nechet/zx-spectrum-fpga-tang-nano-20k/Krasnodar-48-fpga/KiCad-US/Krasnodar-48-US.kicad_sch

## KiCad design Krasnodar-48-fpga/KiCad-US/Krasnodar-48-US.kicad_sch (2026-10-19)

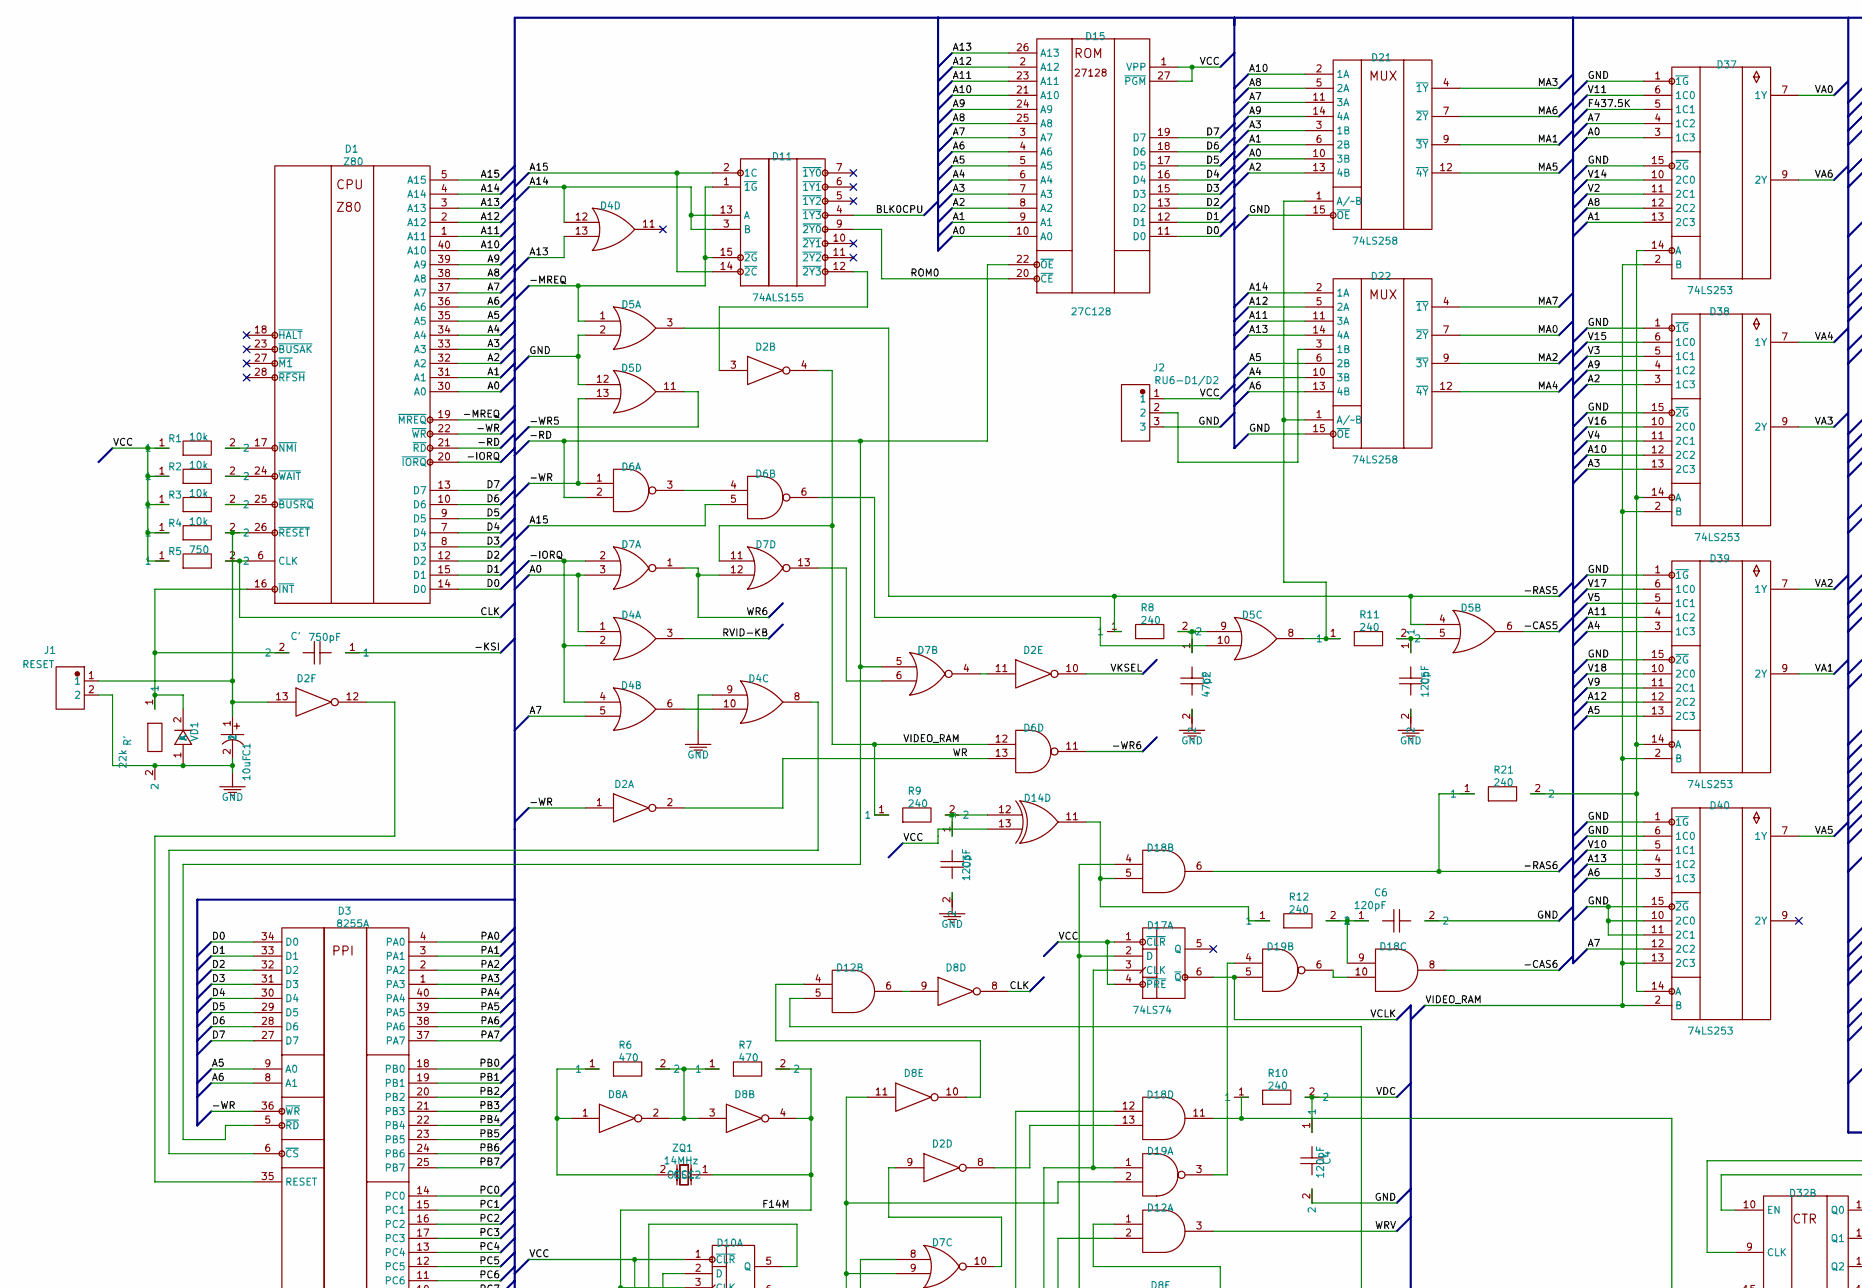
[picture p2: schematic Krasnodar-48-US.kicad_sch, part in row 1, column 1]

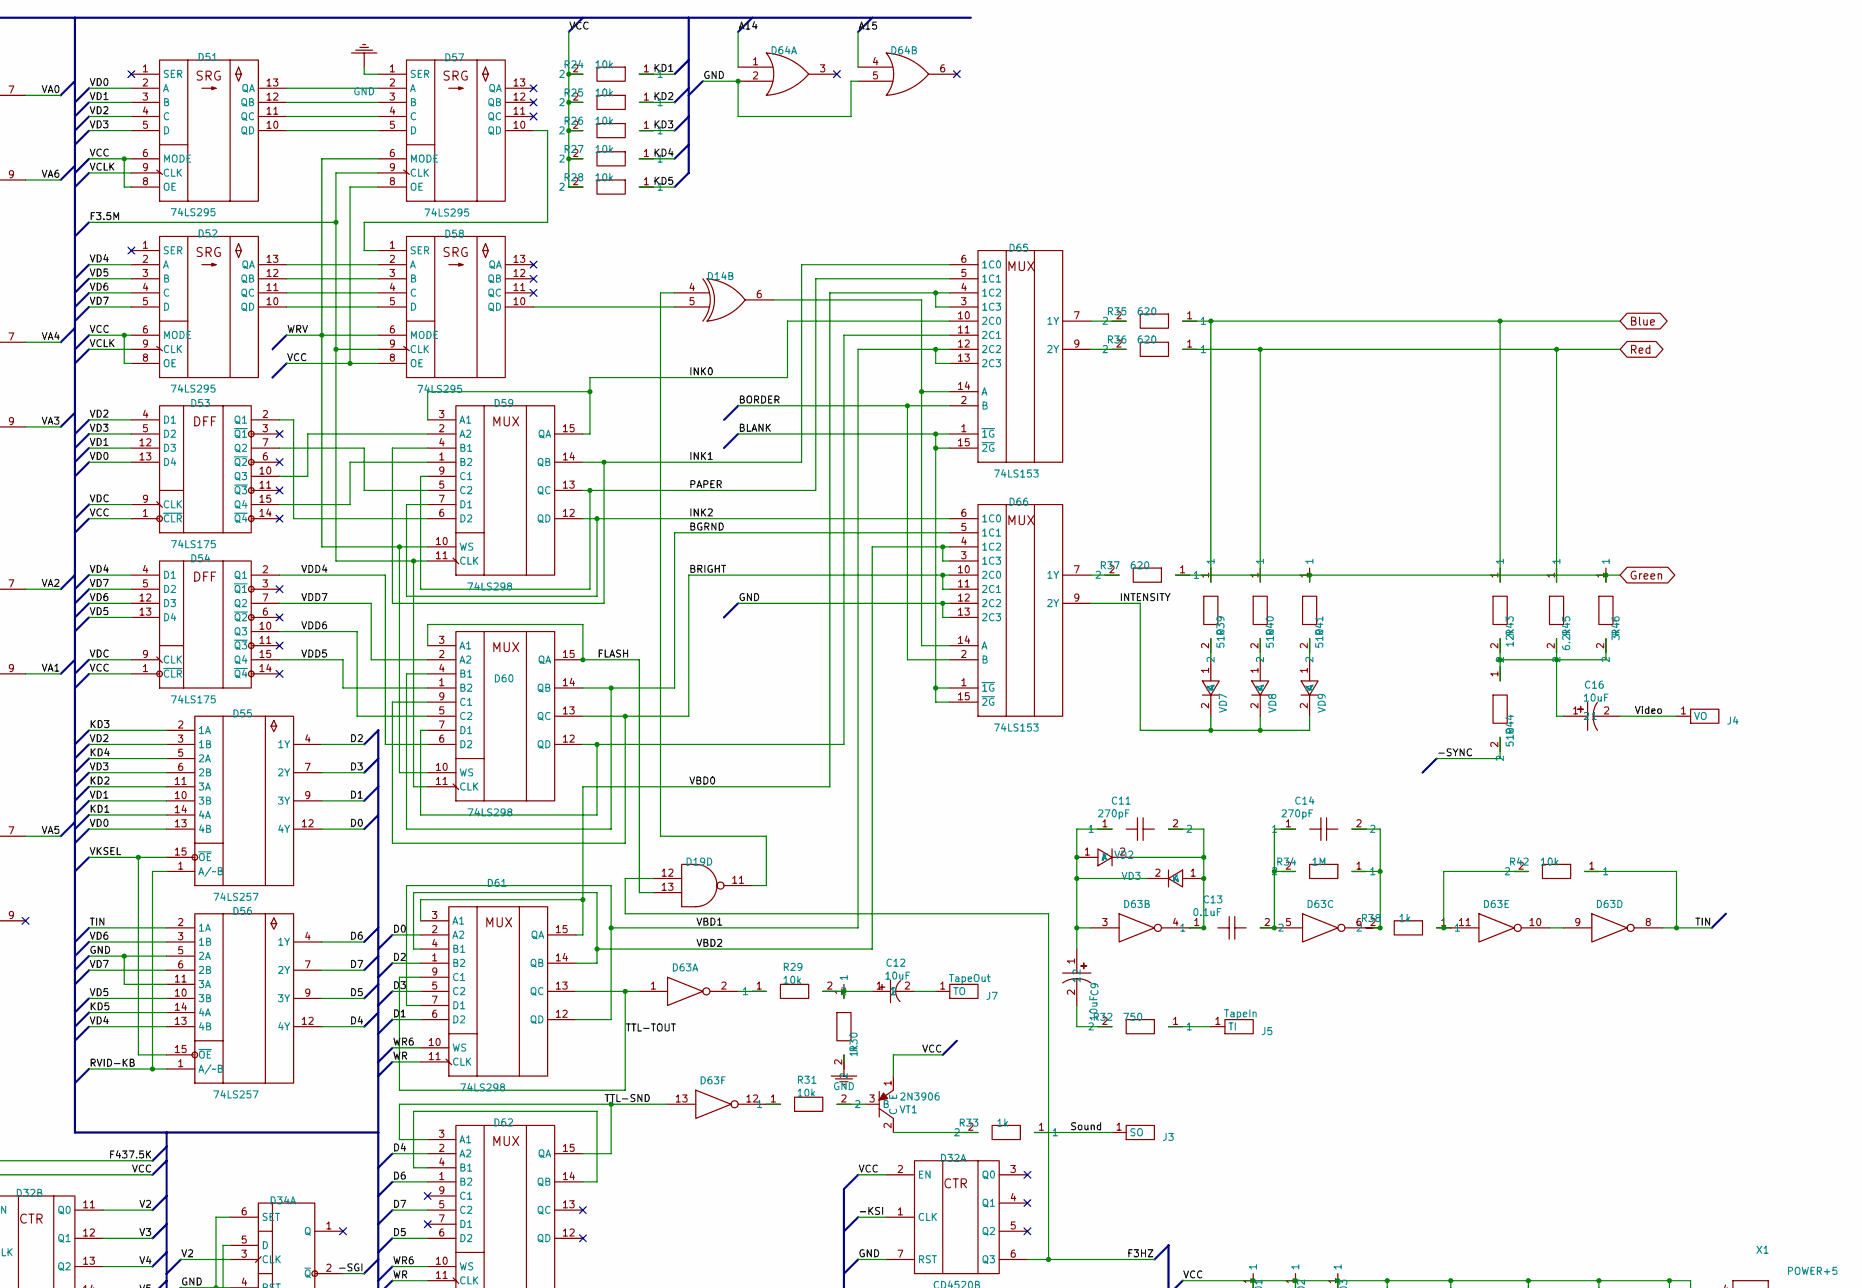
[picture p3: schematic Krasnodar-48-US.kicad_sch, part in row 1, column 2]

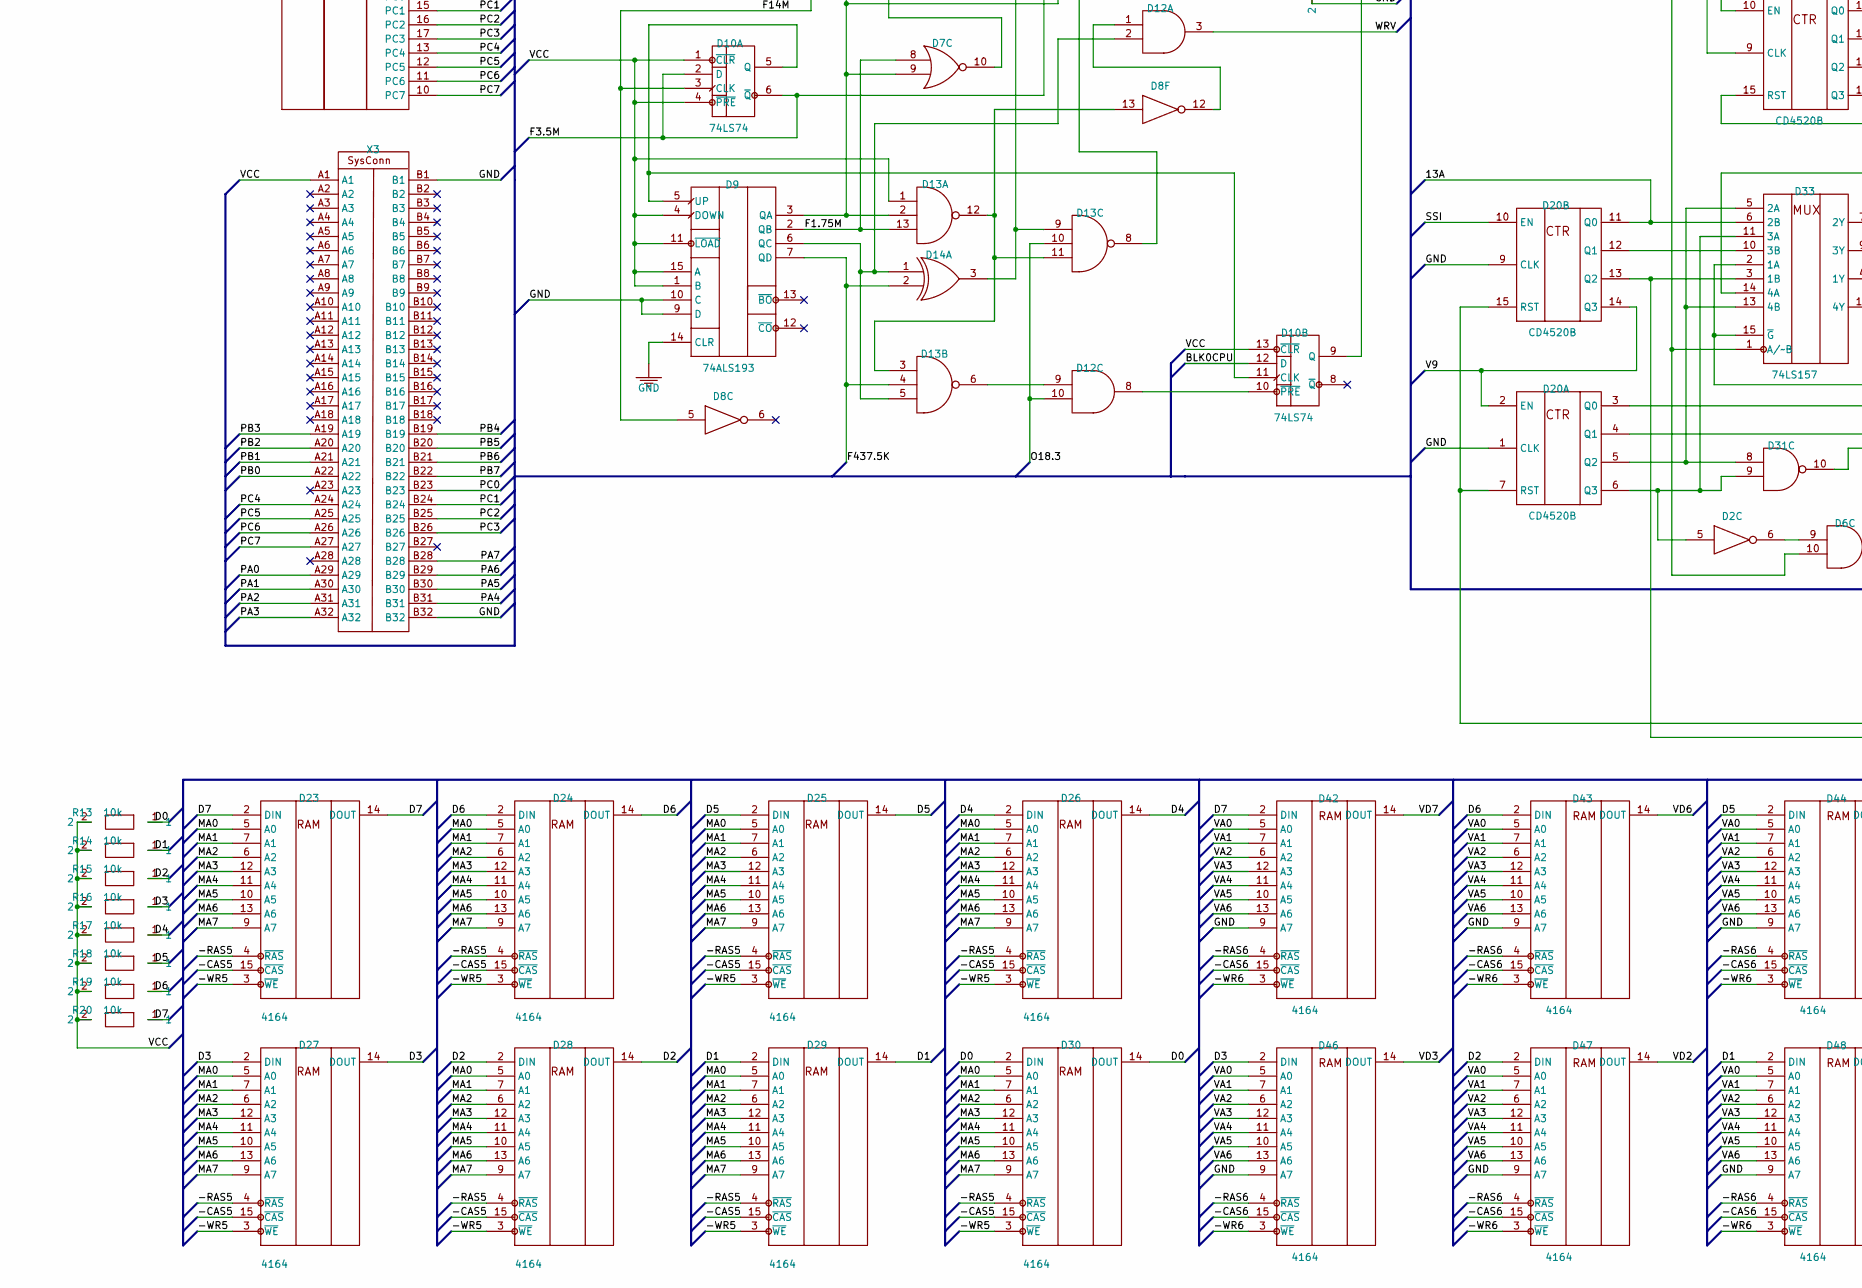
[picture p4: schematic Krasnodar-48-US.kicad_sch, part in row 2, column 1]

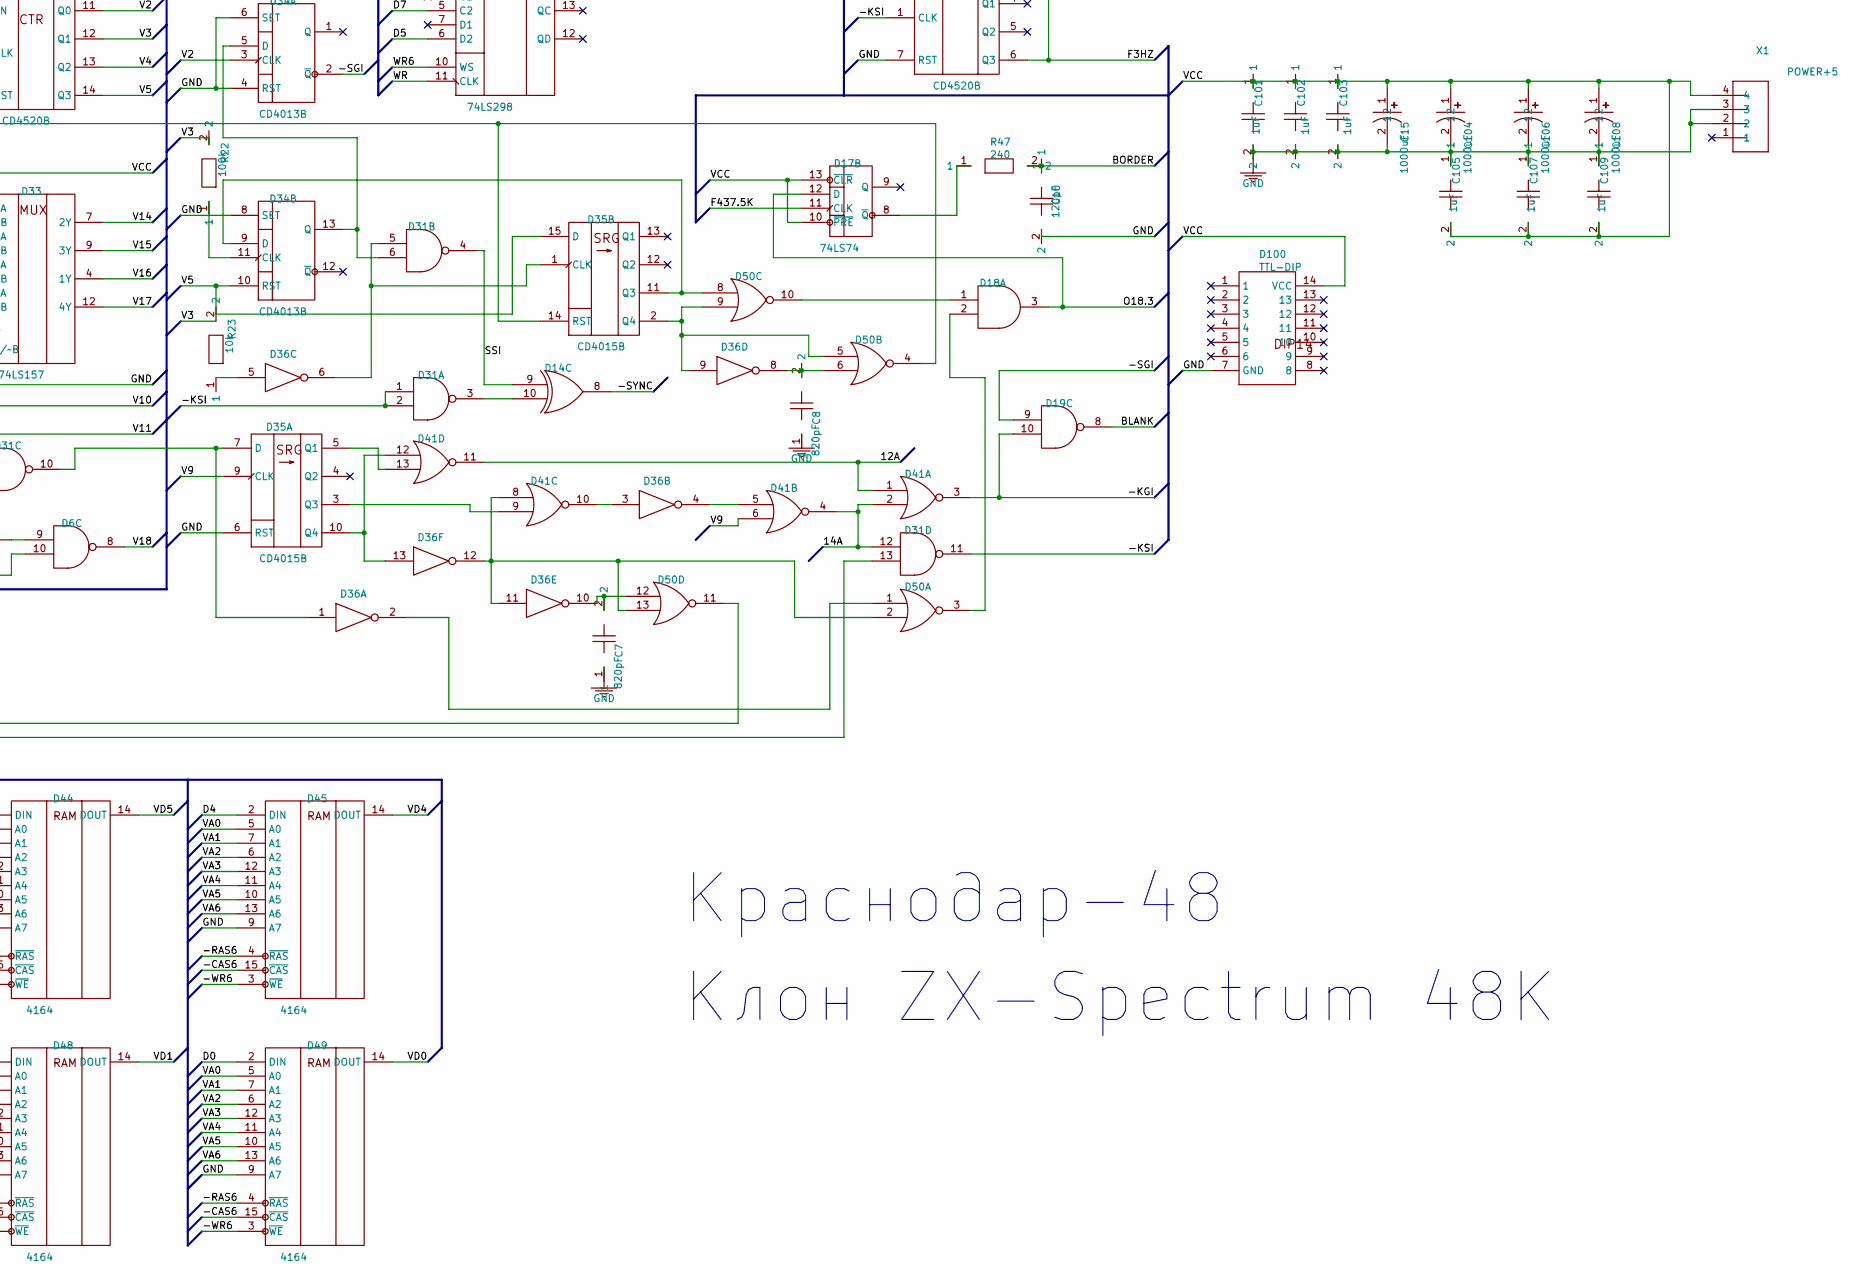
[picture p5: schematic Krasnodar-48-US.kicad_sch, part in row 2, column 2]

Parts:
C1: 10uF; MPN ECLJ0612220M101P00; LCSC C156809
C2: 47pF; C_Disc_D5.0mm_W2.5mm_P5.00mm; MPN CK45-R3AD152K-VRY; LCSC C340608
C3: 120pF; MPN CK45-R3AD152K-VRY; LCSC C340608
C4, C6: 120pF; C_Disc_D5.0mm_W2.5mm_P2.50mm; MPN CK45-R3AD152K-VRY; LCSC C340608
C5, C10: 120pF; C_Disc_D5.0mm_W2.5mm_P5.00mm; MPN CK45-R3AD152K-VRY; LCSC C340608
C7, C8: 820pF; C_Disc_D5.0mm_W2.5mm_P5.00mm; MPN CK45-R3AD152K-VRY; LCSC C340608
C9, C16: 10uF; CP_Radial_D5.0mm_P2.00mm; MPN 25MH710MEFCT55X7; LCSC C473156
C11, C14: 270pF; C_Disc_D5.0mm_W2.5mm_P2.50mm; MPN CK45-R3AD152K-VRY; LCSC C340608
C12: 10uF; CP_Radial_D5.0mm_P2.00mm; MPN ECLJ0612220M101P00; LCSC C156809
C13: 0.1uF; C_Disc_D5.0mm_W2.5mm_P2.50mm; MPN CK45-R3AD152K-VRY; LCSC C340608
C15, C104, C106, C108: 1000uF; CP_Radial_D6.3mm_P2.50mm; MPN SHW1000UF6.3V6.3X11; LCSC C494544
C101, C102, C103, C105, C107, C109: 1uF; C_Disc_D5.0mm_W2.5mm_P5.00mm; MPN CK45-R3AD152K-VRY; LCSC C340608
C': 750pF; C_Disc_D7.0mm_W2.5mm_P5.00mm; MPN CK45-R3AD152K-VRY; LCSC C340608
D1: Z80; DIP-40_W15.24mm
D2, D8: 74LS04; DIP-14_W7.62mm
D3: 8255A; DIP-40_W15.24mm
D4, D5, D64: 74LS32; DIP-14_W7.62mm
D6, D19: 74LS00; DIP-14_W7.62mm
D7: 74LS02; DIP-14_W7.62mm
D9: 74ALS193; DIP-16_W7.62mm
D10, D17: 74LS74; DIP-14_W7.62mm
D11: 74ALS155; DIP-16_W7.62mm
D12, D18: 74LS08; DIP-14_W7.62mm
D13: 74LS10; DIP-14_W7.62mm
D14: 74LS86; DIP-14_W7.62mm
D15: 27C128; DIP-28_W15.24mm
D20, D32: CD4520B; DIP-16_W7.62mm
D21, D22: 74LS258; DIP-16_W7.62mm
D23, D24, D25, D26, D27, D28, D29, D30, D42, D43, D44, D45, D46, D47, D48, D49: 4164; DIP-16_W7.62mm
D31: CD4011B; DIP-14_W7.62mm
D33: 74LS157; DIP-16_W7.62mm
D34: CD4013B; DIP-14_W7.62mm
D35: CD4015B; DIP-16_W7.62mm
D36, D63: CD4069UB; DIP-14_W7.62mm
D37, D38, D39, D40: 74LS253; DIP-16_W7.62mm
D41, D50: CD4001B; DIP-14_W7.62mm
D51, D52, D57, D58: 74LS295; DIP-14_W7.62mm
D53, D54: 74LS175; DIP-16_W7.62mm
D55, D56: 74LS257; DIP-16_W7.62mm
D59, D60, D61, D62: 74LS298; DIP-16_W7.62mm
D65, D66: 74LS153; DIP-16_W7.62mm
D100: TTL-DIP; DIP-14_W7.62mm
J1: RESET; PinHeader_1x02_P2.54mm_Vertical; MPN 22102021; LCSC C587007
J2: RU6-D1/D2; PinHeader_1x03_P2.54mm_Vertical; MPN A2541WV-3P; LCSC C609572
J3: SND; PinHeader_1x01_P2.54mm_Vertical; LCSC C81276
J4: Video; PinHeader_1x01_P2.54mm_Vertical; LCSC C81276
J5: TapeIn; PinHeader_1x01_P2.54mm_Vertical; LCSC C81276
J7: TapeOut; PinHeader_1x01_P2.54mm_Vertical; LCSC C81276
R1, R2, R3, R4: 10k; R_Axial_DIN0207_L6.3mm_D2.5mm_P7.62mm_Horizontal; MPN RN 1/8W 470R F T/B A1; LCSC C433478
R5: 750; R_Axial_DIN0207_L6.3mm_D2.5mm_P7.62mm_Horizontal; MPN RN 1/8W 470R F T/B A1; LCSC C433478
R6, R7: 470; R_Axial_DIN0204_L3.6mm_D1.6mm_P5.08mm_Horizontal; MPN RN 1/8W 470R F T/B A1; LCSC C433478
R8, R9, R11, R12, R47: 240; R_Axial_DIN0204_L3.6mm_D1.6mm_P5.08mm_Horizontal; MPN RN 1/8W 470R F T/B A1; LCSC C433478
R10, R21: 240; R_Axial_DIN0207_L6.3mm_D2.5mm_P2.54mm_Vertical; MPN RN 1/8W 470R F T/B A1; LCSC C433478
R13, R14, R15, R16, R17, R18, R19, R20, R24, R25, R26, R27, R28, R29, R31, R42: 10k; R_Axial_DIN0207_L6.3mm_D2.5mm_P2.54mm_Vertical; MPN RN 1/8W 470R F T/B A1; LCSC C433478
R22: 100k; R_Axial_DIN0204_L3.6mm_D1.6mm_P5.08mm_Horizontal; MPN RN 1/8W 470R F T/B A1; LCSC C433478
R23: 10k; R_Axial_DIN0204_L3.6mm_D1.6mm_P5.08mm_Horizontal; MPN RN 1/8W 470R F T/B A1; LCSC C433478
R30, R33, R38: 1k; R_Axial_DIN0207_L6.3mm_D2.5mm_P2.54mm_Vertical; MPN RN 1/8W 470R F T/B A1; LCSC C433478
R32: 750; R_Axial_DIN0207_L6.3mm_D2.5mm_P2.54mm_Vertical; MPN RN 1/8W 470R F T/B A1; LCSC C433478
R34: 1M; R_Axial_DIN0207_L6.3mm_D2.5mm_P2.54mm_Vertical; MPN RN 1/8W 470R F T/B A1; LCSC C433478
R35, R36, R37: 620; R_Axial_DIN0207_L6.3mm_D2.5mm_P2.54mm_Vertical; MPN RN 1/8W 470R F T/B A1; LCSC C433478
R39, R40, R41, R44: 510; R_Axial_DIN0207_L6.3mm_D2.5mm_P2.54mm_Vertical; MPN RN 1/8W 470R F T/B A1; LCSC C433478
R43: 12k; R_Axial_DIN0207_L6.3mm_D2.5mm_P2.54mm_Vertical; MPN RN 1/8W 470R F T/B A1; LCSC C433478
R45: 6.2k; R_Axial_DIN0207_L6.3mm_D2.5mm_P2.54mm_Vertical; MPN RN 1/8W 470R F T/B A1; LCSC C433478
R46: 3k; R_Axial_DIN0207_L6.3mm_D2.5mm_P2.54mm_Vertical; MPN RN 1/8W 470R F T/B A1; LCSC C433478
R': 22k; R_Axial_DIN0207_L6.3mm_D2.5mm_P7.62mm_Horizontal; MPN RN 1/8W 470R F T/B A1; LCSC C433478
VD1: 1N4148; D_DO-35_SOD27_P7.62mm_Horizontal
VD2, VD3, VD7, VD8, VD9: 1N4148
VT1: 2N3906; MPN Russia; LCSC КТ361
X1: POWER+5; Molex_KK-254_AE-6410-04A_1x04_P2.54mm_Vertical
X3: SysExt
ZQ1: 14MHz; Crystal_HC49-U_Vertical; MPN X49UD12MSD2SC; LCSC C2188

Connections:
12A: D41.1, D41.11
13A: D20.11 (Q0), D33.6 (2B)
14A: D31.12, D41.2, D41.4
-CAS5: D5.6, D23.15 (~CAS), D24.15 (~CAS), D25.15 (~CAS), D26.15 (~CAS), D27.15 (~CAS), D28.15 (~CAS), D29.15 (~CAS), D30.15 (~CAS)
-CAS6: D18.8, D42.15 (~CAS), D43.15 (~CAS), D44.15 (~CAS), D45.15 (~CAS), D46.15 (~CAS), D47.15 (~CAS), D48.15 (~CAS), D49.15 (~CAS)
-IORQ: D1.20 (~IORQ), D4.2, D4.4, D7.2
-KGI: D19.10, D41.3
-KSI: C'.1, D31.1, D31.2, D31.11, D32.1 (CLK)
-MREQ: D1.19 (~MREQ), D5.1, D11.1 (~1G), D11.15 (~2G)
-RAS5: D5.3, D5.4, D23.4 (~RAS), D24.4 (~RAS), D25.4 (~RAS), D26.4 (~RAS), D27.4 (~RAS), D28.4 (~RAS), D29.4 (~RAS), D30.4 (~RAS), R8.1
-RAS6: D18.6, D42.4 (~RAS), D43.4 (~RAS), D44.4 (~RAS), D45.4 (~RAS), D46.4 (~RAS), D47.4 (~RAS), D48.4 (~RAS), D49.4 (~RAS), R21.1
-RD: D1.21 (~RD), D3.5 (~RD), D6.2, D7.5, D15.22 (~OE)
-SGI: D19.9, D34.2 (~Q)
-SYNC: D14.8, R44.2
-WR: D1.22 (~WR), D2.1, D3.36 (~WR), D5.13, D6.1
-WR5: D5.11, D23.3 (~WE), D24.3 (~WE), D25.3 (~WE), D26.3 (~WE), D27.3 (~WE), D28.3 (~WE), D29.3 (~WE), D30.3 (~WE)
-WR6: D6.11, D42.3 (~WE), D43.3 (~WE), D44.3 (~WE), D45.3 (~WE), D46.3 (~WE), D47.3 (~WE), D48.3 (~WE), D49.3 (~WE)
A0: D1.30 (A0), D4.1, D7.3, D15.10 (A0), D21.10 (3B), D37.3 (1C3)
A1: D1.31 (A1), D15.9 (A1), D21.6 (2B), D37.13 (2C3)
A2: D1.32 (A2), D15.8 (A2), D21.13 (4B), D38.3 (1C3)
A3: D1.33 (A3), D15.7 (A3), D21.3 (1B), D38.13 (2C3)
A4: D1.34 (A4), D15.6 (A4), D22.10 (3B), D39.3 (1C3)
A5: D1.35 (A5), D3.9 (A0), D15.5 (A5), D22.6 (2B), D39.13 (2C3)
A6: D1.36 (A6), D3.8 (A1), D15.4 (A6), D22.13 (4B), D40.3 (1C3)
A7: D1.37 (A7), D4.5, D15.3 (A7), D21.11 (3A), D37.4 (1C2), D40.12 (2C2)
A8: D1.38 (A8), D15.25 (A8), D21.5 (2A), D37.12 (2C2)
A9: D1.39 (A9), D15.24 (A9), D21.14 (4A), D38.4 (1C2)
A10: D1.40 (A10), D15.21 (A10), D21.2 (1A), D38.12 (2C2)
A11: D1.1 (A11), D15.23 (A11), D22.11 (3A), D39.4 (1C2)
A12: D1.2 (A12), D15.2 (A12), D22.5 (2A), D39.12 (2C2)
A13: D1.3 (A13), D4.13, D15.26 (A13), D22.14 (4A), D40.4 (1C2)
A14: D1.4 (A14), D4.12, D11.3 (B), D11.13 (A), D22.2 (1A), D64.1
A15: D1.5 (A15), D6.5, D11.2 (1C), D11.14 (~2C), D64.4
BGRND: D60.4 (B1), D60.14 (QB), D66.5 (1C1)
BLANK: D19.8, D65.1 (~1G), D65.15 (~2G), D66.1 (~1G), D66.15 (~2G)
BLK0CPU: D10.12 (D), D11.4 (~1Y3)
BORDER: C10.1, D65.2 (B), D66.2 (B), R47.2
BRIGHT: D60.9 (C1), D60.13 (QC), D66.10 (2C0), D66.11 (2C1)
Blue: R35.1, R39.1, R43.1
CLK: D1.6 (CLK), D8.8, R5.2
D0: D1.14 (D0), D3.34 (D0), D15.11 (D0), D30.2 (DIN), D30.14 (DOUT), D49.2 (DIN), D55.12 (4Y), D61.2 (A2), R13.1
D1: D1.15 (D1), D3.33 (D1), D15.12 (D1), D29.2 (DIN), D29.14 (DOUT), D48.2 (DIN), D55.9 (3Y), D61.6 (D2), R14.1
D2: D1.12 (D2), D3.32 (D2), D15.13 (D2), D28.2 (DIN), D28.14 (DOUT), D47.2 (DIN), D55.4 (1Y), D61.1 (B2), R15.1
D3: D1.8 (D3), D3.31 (D3), D15.15 (D3), D27.2 (DIN), D27.14 (DOUT), D46.2 (DIN), D55.7 (2Y), D61.5 (C2), R16.1
D4: D1.7 (D4), D3.30 (D4), D15.16 (D4), D26.2 (DIN), D26.14 (DOUT), D45.2 (DIN), D56.12 (4Y), D62.2 (A2), R17.1
D5: D1.9 (D5), D3.29 (D5), D15.17 (D5), D25.2 (DIN), D25.14 (DOUT), D44.2 (DIN), D56.9 (3Y), D62.6 (D2), R18.1
D6: D1.10 (D6), D3.28 (D6), D15.18 (D6), D24.2 (DIN), D24.14 (DOUT), D43.2 (DIN), D56.4 (1Y), D62.1 (B2), R19.1
D7: D1.13 (D7), D3.27 (D7), D15.19 (D7), D23.2 (DIN), D23.14 (DOUT), D42.2 (DIN), D56.7 (2Y), D62.5 (C2), R20.1
F1.75M: D7.8, D9.2 (QB), D13.13
F3.5M: D10.2 (D), D10.6 (~Q), D17.3 (CLK), D19.1, D57.9 (CLK), D58.9 (CLK), D59.11 (CLK), D60.11 (CLK)
F3HZ: D19.12, D32.6 (Q3)
F14M: D8.4, D8.5, D10.3 (CLK), R7.2, ZQ1.1 (OSC1)
F437.5K: D9.7 (QD), D13.4, D14.2, D17.11 (CLK), D32.9 (CLK), D37.5 (1C1)
FLASH: D19.13, D60.3 (A1), D60.15 (QA)
GND: C1.2, C2.2, C3.2, C4.2, C5.2, C6.2, C7.1, C8.1, C10.2, C15.2, C101.2, C102.2, C103.2, C104.2, C105.1, C106.2, C107.1, C108.2, C109.1, D4.9, D5.2, D5.12, D9.9 (D), D9.10 (C), D9.14 (CLR), D20.1 (CLK), D20.9 (CLK), D21.15 (~OE), D22.15 (~OE), D32.7 (RST), D33.2 (1A), D33.15 (~G), D34.4 (RST), D34.6 (SET), D34.8 (SET), D35.6 (RST), D37.1 (~1G), D37.15 (~2G), D38.1 (~1G), D38.15 (~2G), D39.1 (~1G), D39.15 (~2G), D40.1 (~1G), D40.6 (1C0), D40.10 (2C0), D40.11 (2C1), D40.15 (~2G), D42.9 (A7), D43.9 (A7), D44.9 (A7), D45.9 (A7), D46.9 (A7), D47.9 (A7), D48.9 (A7), D49.9 (A7), D56.5 (2A), D56.11 (3A), D57.1 (SER), D64.2, D64.5, D66.12 (2C2), D66.13 (2C3), D100.7 (GND), J1.2, J2.3, R30.2, R'.2, VD1.1 (A), X1.2, X1.3, X3.B1, X3.B32
Green: R37.1, R41.1, R46.1
INK0: D59.3 (A1), D59.15 (QA), D65.10 (2C0)
INK1: D59.4 (B1), D59.14 (QB), D65.6 (1C0)
INK2: D59.7 (D1), D59.12 (QD), D66.6 (1C0)
INTENSITY: D66.9 (2Y), VD7.2 (K), VD8.2 (K), VD9.2 (K)
KD1: D55.14 (4A), R24.1
KD2: D55.11 (3A), R25.1
KD3: D55.2 (1A), R26.1
KD4: D55.5 (2A), R27.1
KD5: D56.14 (4A), R28.1
MA0: D22.7 (~2Y), D23.5 (A0), D24.5 (A0), D25.5 (A0), D26.5 (A0), D27.5 (A0), D28.5 (A0), D29.5 (A0), D30.5 (A0)
MA1: D21.9 (~3Y), D23.7 (A1), D24.7 (A1), D25.7 (A1), D26.7 (A1), D27.7 (A1), D28.7 (A1), D29.7 (A1), D30.7 (A1)
MA2: D22.9 (~3Y), D23.6 (A2), D24.6 (A2), D25.6 (A2), D26.6 (A2), D27.6 (A2), D28.6 (A2), D29.6 (A2), D30.6 (A2)
MA3: D21.4 (~1Y), D23.12 (A3), D24.12 (A3), D25.12 (A3), D26.12 (A3), D27.12 (A3), D28.12 (A3), D29.12 (A3), D30.12 (A3)
MA4: D22.12 (~4Y), D23.11 (A4), D24.11 (A4), D25.11 (A4), D26.11 (A4), D27.11 (A4), D28.11 (A4), D29.11 (A4), D30.11 (A4)
MA5: D21.12 (~4Y), D23.10 (A5), D24.10 (A5), D25.10 (A5), D26.10 (A5), D27.10 (A5), D28.10 (A5), D29.10 (A5), D30.10 (A5)
MA6: D21.7 (~2Y), D23.13 (A6), D24.13 (A6), D25.13 (A6), D26.13 (A6), D27.13 (A6), D28.13 (A6), D29.13 (A6), D30.13 (A6)
MA7: D22.4 (~1Y), D23.9 (A7), D24.9 (A7), D25.9 (A7), D26.9 (A7), D27.9 (A7), D28.9 (A7), D29.9 (A7), D30.9 (A7)
unnamed: C1.1, D1.26 (~RESET), D2.13, J1.1, R4.2
unnamed: C2.1, D5.9, R8.2
unnamed: C3.1, D14.12, R9.2
unnamed: C5.1, D5.5, R11.2
unnamed: C6.1, D18.9, R12.2
unnamed: C7.2, D36.10, D50.12
unnamed: C8.2, D36.8, D50.6
unnamed: C9.2, R32.2
unnamed: C9.1, C11.1, D63.3, VD2.1 (A), VD3.2 (K)
unnamed: C11.2, C13.1, D63.4, VD2.2 (K), VD3.1 (A)
unnamed: C12.1, R29.2, R30.1
unnamed: C12.2, J7.1
unnamed: C13.2, C14.1, D63.5, R34.2
unnamed: C14.2, D63.6, R34.1, R38.2
unnamed: C16.1, R43.2, R44.1, R45.2, R46.2
unnamed: C'.2, D1.16 (~INT), R'.1, VD1.2 (K)
unnamed: D1.17 (~NMI), R1.2
unnamed: D1.24 (~WAIT), R2.2
unnamed: D1.25 (~BUSRQ), R3.2
unnamed: D2.5, D20.6 (Q3), D31.9, D33.11 (3A)
unnamed: D2.6, D6.9
unnamed: D2.9, D7.10
unnamed: D2.11, D7.4
unnamed: D2.12, D3.35 (RESET)
unnamed: D3.6 (~CS), D4.8
unnamed: D4.6, D4.10
unnamed: D5.10, D6.6
unnamed: D6.3, D6.4
unnamed: D6.14 (VCC), D7.14 (VCC)
unnamed: D7.6, D7.13
unnamed: D8.1, R6.1, ZQ1.2 (OSC2)
unnamed: D8.2, D8.3, R6.2, R7.1
unnamed: D10.9 (Q), D12.5
unnamed: D10.10 (~PRE), D12.8
unnamed: D9.5 (UP), D10.5 (Q), D10.11 (CLK)
unnamed: D2.3, D11.12 (~2Y3)
unnamed: D8.12, D12.1
unnamed: D9.6 (QC), D12.2, D13.5, D14.1
unnamed: D8.10, D12.4
unnamed: D8.9, D12.6
unnamed: D12.9, D13.6
unnamed: D7.9, D8.11, D9.3 (QA), D13.2, D19.2
unnamed: D13.8, D17.2 (D), D18.4
unnamed: D13.9, D14.3, D18.12
unnamed: D8.13, D13.3, D13.11, D13.12
unnamed: D14.4, D19.11
unnamed: D14.5, D58.10 (QD)
unnamed: D14.6, D65.14 (A), D66.14 (A)
unnamed: D14.10, D31.3
unnamed: D14.11, D18.5, R12.1
unnamed: D17.8 (~Q), R47.1
unnamed: D18.1, D50.10
unnamed: D18.2, D50.3
unnamed: D18.10, D19.6
unnamed: D6.10, D18.11, D33.1 (A/~B), R10.1
unnamed: D2.8, D18.13
unnamed: D19.3, D19.4
unnamed: D20.5 (Q2), D31.8, D33.5 (2A), D33.13 (4B)
unnamed: D20.12 (Q1), D33.10 (3B)
unnamed: D20.13 (Q2), D31.13, D33.3 (1B)
unnamed: D20.7 (RST), D20.15 (RST), D50.11
unnamed: D5.8, D21.1 (A/~B), D22.1 (A/~B), R11.1
unnamed: D22.3 (1B), J2.2
unnamed: D31.5, D35.1 (CLK), D36.6
unnamed: D31.6, D34.5 (D), D34.13 (Q)
unnamed: D31.10, D35.7 (D), D36.1
unnamed: D32.15 (RST), D35.14 (RST), D50.4
unnamed: D34.9 (D), D35.11 (Q3), D50.8
unnamed: D34.11 (CLK), R22.1
unnamed: D35.2 (Q4), D36.9, D50.5, D50.9
unnamed: D35.3 (Q3), D41.9
unnamed: D35.5 (Q1), D41.13
unnamed: D35.10 (Q4), D36.13, D41.12
unnamed: D36.2, D50.1
unnamed: D36.3, D41.10
unnamed: D36.4, D41.5
unnamed: D36.5, R23.1
unnamed: D36.11, D36.12, D41.8, D50.2, D50.13
unnamed: D37.14 (A), D38.14 (A), D39.14 (A), D40.14 (A), R21.2
unnamed: D51.10 (QD), D57.5 (D)
unnamed: D51.11 (QC), D57.4 (C)
unnamed: D51.12 (QB), D57.3 (B)
unnamed: D51.13 (QA), D57.2 (A)
unnamed: D52.10 (QD), D58.5 (D)
unnamed: D52.11 (QC), D58.4 (C)
unnamed: D52.12 (QB), D58.3 (B)
unnamed: D52.13 (QA), D58.2 (A)
unnamed: D53.2 (Q1), D59.6 (D2)
unnamed: D53.7 (Q2), D59.5 (C2)
unnamed: D53.10 (Q3), D59.2 (A2)
unnamed: D53.15 (Q4), D59.1 (B2)
unnamed: D57.10 (QD), D58.1 (SER)
unnamed: D60.7 (D1), D60.12 (QD), D65.11 (2C1)
unnamed: D62.4 (B1), D62.14 (QB)
unnamed: D63.2, R29.1
unnamed: D63.9, D63.10
unnamed: D63.11, R38.1, R42.2
unnamed: D63.12, R31.1
unnamed: D65.7 (1Y), R35.2
unnamed: D65.9 (2Y), R36.2
unnamed: D66.7 (1Y), R37.2
unnamed: J5.1, R32.1
unnamed: R31.2, VT1.3 (B)
unnamed: R33.2, VT1.2 (C)
unnamed: R39.2, VD7.1 (A)
unnamed: R40.2, VD8.1 (A)
unnamed: R41.2, VD9.1 (A)
O18.3: D12.10, D13.10, D17.12 (D), D18.3
PA0: D3.4 (PA0), X3.A29
PA1: D3.3 (PA1), X3.A30
PA2: D3.2 (PA2), X3.A31
PA3: D3.1 (PA3), X3.A32
PA4: D3.40 (PA4), X3.B31
PA5: D3.39 (PA5), X3.B30
PA6: D3.38 (PA6), X3.B29
PA7: D3.37 (PA7), X3.B28
PAPER: D59.9 (C1), D59.13 (QC), D65.5 (1C1)
PB0: D3.18 (PB0), X3.A22
PB1: D3.19 (PB1), X3.A21
PB2: D3.20 (PB2), X3.A20
PB3: D3.21 (PB3), X3.A19
PB4: D3.22 (PB4), X3.B19
PB5: D3.23 (PB5), X3.B20
PB6: D3.24 (PB6), X3.B21
PB7: D3.25 (PB7), X3.B22
PC0: D3.14 (PC0), X3.B23
PC1: D3.15 (PC1), X3.B24
PC2: D3.16 (PC2), X3.B25
PC3: D3.17 (PC3), X3.B26
PC4: D3.13 (PC4), X3.A24
PC5: D3.12 (PC5), X3.A25
PC6: D3.11 (PC6), X3.A26
PC7: D3.10 (PC7), X3.A27
ROM0: D11.9 (~2Y0), D15.20 (~CE)
RVID-KB: D4.3, D55.1 (A/~B), D56.1 (A/~B)
Red: R36.1, R40.1, R45.1
SSI: D14.9, D20.10 (EN), D31.4
Sound: J3.1, R33.1
TIN: D56.2 (1A), D63.8, R42.1
TTL-SND: D62.3 (A1), D62.15 (QA), D63.13
TTL-TOUT: D61.9 (C1), D61.13 (QC), D63.1
V2: D32.11 (Q0), D34.3 (CLK), D37.11 (2C1)
V3: D32.12 (Q1), D38.5 (1C1), R22.2, R23.2
V4: D32.13 (Q2), D38.11 (2C1)
V5: D32.14 (Q3), D34.10 (RST), D35.15 (D), D39.5 (1C1)
V9: D20.2 (EN), D20.14 (Q3), D35.9 (CLK), D39.11 (2C1), D41.6
V10: D20.3 (Q0), D40.5 (1C1)
V11: D20.4 (Q1), D37.6 (1C0)
V14: D33.7 (2Y), D37.10 (2C0)
V15: D33.9 (3Y), D38.6 (1C0)
V16: D33.4 (1Y), D38.10 (2C0)
V17: D33.12 (4Y), D39.6 (1C0)
V18: D6.8, D39.10 (2C0)
VA0: D37.7 (1Y), D42.5 (A0), D43.5 (A0), D44.5 (A0), D45.5 (A0), D46.5 (A0), D47.5 (A0), D48.5 (A0), D49.5 (A0)
VA1: D39.9 (2Y), D42.7 (A1), D43.7 (A1), D44.7 (A1), D45.7 (A1), D46.7 (A1), D47.7 (A1), D48.7 (A1), D49.7 (A1)
VA2: D39.7 (1Y), D42.6 (A2), D43.6 (A2), D44.6 (A2), D45.6 (A2), D46.6 (A2), D47.6 (A2), D48.6 (A2), D49.6 (A2)
VA3: D38.9 (2Y), D42.12 (A3), D43.12 (A3), D44.12 (A3), D45.12 (A3), D46.12 (A3), D47.12 (A3), D48.12 (A3), D49.12 (A3)
VA4: D38.7 (1Y), D42.11 (A4), D43.11 (A4), D44.11 (A4), D45.11 (A4), D46.11 (A4), D47.11 (A4), D48.11 (A4), D49.11 (A4)
VA5: D40.7 (1Y), D42.10 (A5), D43.10 (A5), D44.10 (A5), D45.10 (A5), D46.10 (A5), D47.10 (A5), D48.10 (A5), D49.10 (A5)
VA6: D37.9 (2Y), D42.13 (A6), D43.13 (A6), D44.13 (A6), D45.13 (A6), D46.13 (A6), D47.13 (A6), D48.13 (A6), D49.13 (A6)
VBD0: D61.3 (A1), D61.15 (QA), D65.3 (1C3), D65.4 (1C2)
VBD1: D61.7 (D1), D61.12 (QD), D65.12 (2C2), D65.13 (2C3)
VBD2: D61.4 (B1), D61.14 (QB), D66.3 (1C3), D66.4 (1C2)
VCC: C15.1, C101.1, C102.1, C103.1, C104.1, C105.2, C106.1, C107.2, C108.1, C109.2, D9.1 (B), D9.4 (DOWN), D9.11 (~LOAD), D9.15 (A), D10.1 (~CLR), D10.4 (~PRE), D10.13 (~CLR), D13.1, D14.13, D15.1 (VPP), D15.27 (~PGM), D17.1 (~CLR), D17.4 (~PRE), D17.10 (~PRE), D17.13 (~CLR), D32.2 (EN), D32.10 (EN), D33.14 (4A), D51.6 (MODE), D51.8 (OE), D52.6 (MODE), D52.8 (OE), D53.1 (~CLR), D54.1 (~CLR), D57.8 (OE), D58.8 (OE), D100.14 (VCC), J2.1, R1.1, R2.1, R3.1, R4.1, R5.1, R13.2, R14.2, R15.2, R16.2, R17.2, R18.2, R19.2, R20.2, R24.2, R25.2, R26.2, R27.2, R28.2, VT1.1 (E), X1.4, X3.A1
VCLK: D17.6 (~Q), D19.5, D51.9 (CLK), D52.9 (CLK)
VD0: D49.14 (DOUT), D51.2 (A), D53.13 (D4), D55.13 (4B)
VD1: D48.14 (DOUT), D51.3 (B), D53.12 (D3), D55.10 (3B)
VD2: D47.14 (DOUT), D51.4 (C), D53.4 (D1), D55.3 (1B)
VD3: D46.14 (DOUT), D51.5 (D), D53.5 (D2), D55.6 (2B)
VD4: D45.14 (DOUT), D52.2 (A), D54.4 (D1), D56.13 (4B)
VD5: D44.14 (DOUT), D52.3 (B), D54.13 (D4), D56.10 (3B)
VD6: D43.14 (DOUT), D52.4 (C), D54.12 (D3), D56.3 (1B)
VD7: D42.14 (DOUT), D52.5 (D), D54.5 (D2), D56.6 (2B)
VDC: C4.1, D53.9 (CLK), D54.9 (CLK), R10.2
VDD4: D54.2 (Q1), D60.6 (D2)
VDD5: D54.15 (Q4), D60.1 (B2)
VDD6: D54.10 (Q3), D60.5 (C2)
VDD7: D54.7 (Q2), D60.2 (A2)
VIDEO_RAM: D2.4, D6.12, D7.11, D37.2 (B), D38.2 (B), D39.2 (B), D40.2 (B), D40.13 (2C3), R9.1
VKSEL: D2.10, D55.15 (~OE), D56.15 (~OE)
Video: C16.2, J4.1
WR: D2.2, D6.13, D61.11 (CLK), D62.11 (CLK)
WR6: D7.1, D7.12, D61.10 (WS), D62.10 (WS)
WRV: D12.3, D57.6 (MODE), D58.6 (MODE), D59.10 (WS), D60.10 (WS)

Notes on the sheet:
Клон ZX-Spectrum 48К
Краснодар-48
