nechet/zx-spectrum-fpga-tang-nano-20k/Krasnodar-48-fpga/Verilog/synth/lib_sync.v

// -----------------------------------------------------------------------------
// 74LS / 74ALS parts used by Krasnodar-48, as behavioural models.
//
// Every port is named after its DIP pin (p1 … pN) so that the generated
// netlist can wire chips up mechanically, with no pin-name mapping to get
// wrong.  Supply pins are present but unused.
//
// See Tools/part-equivalents.md for the Soviet part each of these stands in
// for (К555ЛА3 = 74LS00, and so on).
// -----------------------------------------------------------------------------
`timescale 1ns / 1ps

// --- 74LS00  quad 2-input NAND ------------------------------------ К555ЛА3 --
module ttl_7400 (input p1, p2, p4, p5, p9, p10, p12, p13,
                 output p3, p6, p8, p11,
                 input p7, p14);
  assign p3  = ~(p1  & p2);
  assign p6  = ~(p4  & p5);
  assign p8  = ~(p9  & p10);
  assign p11 = ~(p12 & p13);
endmodule

// --- 74LS02  quad 2-input NOR ------------------------------------- К555ЛЕ1 --
module ttl_7402 (input p2, p3, p5, p6, p8, p9, p11, p12,
                 output p1, p4, p10, p13,
                 input p7, p14);
  assign p1  = ~(p2  | p3);
  assign p4  = ~(p5  | p6);
  assign p10 = ~(p8  | p9);
  assign p13 = ~(p11 | p12);
endmodule

// --- 74LS04  hex inverter ----------------------------------------- К555ЛН1 --
module ttl_7404 (input p1, p3, p5, p9, p11, p13,
                 output p2, p4, p6, p8, p10, p12,
                 input p7, p14);
  assign p2  = ~p1;
  assign p4  = ~p3;
  assign p6  = ~p5;
  assign p8  = ~p9;
  assign p10 = ~p11;
  assign p12 = ~p13;
endmodule

// --- 74LS08  quad 2-input AND ------------------------------------- К555ЛИ1 --
module ttl_7408 (input p1, p2, p4, p5, p9, p10, p12, p13,
                 output p3, p6, p8, p11,
                 input p7, p14);
  assign p3  = p1  & p2;
  assign p6  = p4  & p5;
  assign p8  = p9  & p10;
  assign p11 = p12 & p13;
endmodule

// --- 74LS10  triple 3-input NAND ---------------------------------- К555ЛА4 --
module ttl_7410 (input p1, p2, p13, p3, p4, p5, p9, p10, p11,
                 output p12, p6, p8,
                 input p7, p14);
  assign p12 = ~(p1 & p2  & p13);
  assign p6  = ~(p3 & p4  & p5);
  assign p8  = ~(p9 & p10 & p11);
endmodule

// --- 74LS32  quad 2-input OR -------------------------------------- К555ЛЛ1 --
module ttl_7432 (input p1, p2, p4, p5, p9, p10, p12, p13,
                 output p3, p6, p8, p11,
                 input p7, p14);
  assign p3  = p1  | p2;
  assign p6  = p4  | p5;
  assign p8  = p9  | p10;
  assign p11 = p12 | p13;
endmodule

// --- 74LS86  quad 2-input XOR ------------------------------------- К555ЛП5 --
module ttl_7486 (input p1, p2, p4, p5, p9, p10, p12, p13,
                 output p3, p6, p8, p11,
                 input p7, p14);
  assign p3  = p1  ^ p2;
  assign p6  = p4  ^ p5;
  assign p8  = p9  ^ p10;
  assign p11 = p12 ^ p13;
endmodule

// --- 74LS74  dual D flip-flop, async preset + clear ---------------- К555ТМ2 --
//   1=/CLR1 2=D1 3=CLK1 4=/PRE1 5=Q1 6=/Q1   13=/CLR2 12=D2 11=CLK2 10=/PRE2 9=Q2 8=/Q2
// --- 74LS175  quad D flip-flop, common clock + clear --------------- К555ТМ8 --
//   1=/CLR 9=CLK  D:4,5,12,13  Q:2,7,10,15  /Q:3,6,11,14
// --- 74ALS193  4-bit up/down binary counter ----------------------- К1533ИЕ7 --
//   15=A 1=B 10=C 9=D  11=/LOAD 14=CLR 5=UP 4=DOWN
//   3=QA 2=QB 6=QC 7=QD  12=/CARRY 13=/BORROW
// --- 74ALS155  dual 2-to-4 decoder / demultiplexer ---------------- К1533ИД4 --
//   13=A 3=B  1=/1G 2=1C  15=/2G 14=/2C
//   The two halves are mirrored in the package: 1Y0..1Y3 run 7,6,5,4 while
//   2Y0..2Y3 run 9,10,11,12.  Confirmed by the memory map this produces on
//   D11 of this board -- ROM at 0000, video RAM at 4000.
module ttl_74155 (input p13, p3, p1, p2, p15, p14,
                  output p7, p6, p5, p4, p12, p11, p10, p9,
                  input p8, p16);
  wire [1:0] sel = {p3, p13};
  // Section 1: data input 1C (pin 1, the schematic's Ea) is active HIGH and
  // strobe /1G (pin 2, Sa) active LOW -- that asymmetry is what makes the
  // '155 a 1-of-8 demultiplexer.  This used to read ~p1 & p2, inverting both.
  // On this board pin 1 is /MREQ and pin 2 is A15, so the bug turned BLK0CPU
  // -- the contention look-ahead, "the CPU is about to touch 4000-7FFF before
  // /MREQ falls" -- into a decode of C000-FFFF with /MREQ active.  It never
  // fired for screen RAM, the CPU was never stalled, and its accesses walked
  // into video fetch cycles: writes landed in wrong cells and the ROM's memory
  // test failed.
  wire en1 =  p1 & ~p2;
  wire en2 = ~p15 & ~p14;
  assign p7  = ~(en1 & (sel == 2'd0));
  assign p6  = ~(en1 & (sel == 2'd1));
  assign p5  = ~(en1 & (sel == 2'd2));
  assign p4  = ~(en1 & (sel == 2'd3));
  assign p9  = ~(en2 & (sel == 2'd0));
  assign p10 = ~(en2 & (sel == 2'd1));
  assign p11 = ~(en2 & (sel == 2'd2));
  assign p12 = ~(en2 & (sel == 2'd3));
endmodule

// --- 74LS153  dual 4-to-1 multiplexer ------------------------------ К555КП2 --
//   14=A 2=B   1=/1G 6,5,4,3 = 1C0..1C3 -> 7=1Y
//              15=/2G 10,11,12,13 = 2C0..2C3 -> 9=2Y
module ttl_74153 (input p14, p2, p1, p6, p5, p4, p3, p15, p10, p11, p12, p13,
                  output p7, p9,
                  input p8, p16);
  wire [1:0] sel = {p2, p14};
  wire d1 = (sel == 2'd0) ? p6 : (sel == 2'd1) ? p5 : (sel == 2'd2) ? p4 : p3;
  wire d2 = (sel == 2'd0) ? p10 : (sel == 2'd1) ? p11 : (sel == 2'd2) ? p12 : p13;
  assign p7 = ~p1  & d1;
  assign p9 = ~p15 & d2;
endmodule

// --- 74LS253  dual 4-to-1 multiplexer, 3-state -------------------- К555КП12 --
//   same pinout as the '153; /G high releases the output instead of forcing 0
// --- 74LS157  quad 2-to-1 multiplexer ---------------------------- КР555КП16 --
//   1=A/B select (0 -> A), 15=/G strobe (1 -> outputs low)
//   A:2,5,11,14   B:3,6,10,13   Y:4,7,9,12
module ttl_74157 (input p1, p15, p2, p3, p5, p6, p11, p10, p14, p13,
                  output p4, p7, p9, p12,
                  input p8, p16);
  wire e = ~p15;
  assign p4  = e & (p1 ? p3  : p2);
  assign p7  = e & (p1 ? p6  : p5);
  assign p9  = e & (p1 ? p10 : p11);
  assign p12 = e & (p1 ? p13 : p14);
endmodule

// --- 74LS257  quad 2-to-1 multiplexer, 3-state ------------------- К555КП11А --
//   same pinout as the '157; 15=/OE releases the outputs
module ttl_74257 (input p1, p15, p2, p3, p5, p6, p11, p10, p14, p13,
                  output p4, p7, p9, p12,
                  input p8, p16);
  assign p4  = p15 ? 1'bz : (p1 ? p3  : p2);
  assign p7  = p15 ? 1'bz : (p1 ? p6  : p5);
  assign p9  = p15 ? 1'bz : (p1 ? p10 : p11);
  assign p12 = p15 ? 1'bz : (p1 ? p13 : p14);
endmodule

// --- 74LS258  quad 2-to-1 multiplexer, inverting, 3-state --------- К555КП14 --
module ttl_74258 (input p1, p15, p2, p3, p5, p6, p11, p10, p14, p13,
                  output p4, p7, p9, p12,
                  input p8, p16);
  assign p4  = p15 ? 1'bz : ~(p1 ? p3  : p2);
  assign p7  = p15 ? 1'bz : ~(p1 ? p6  : p5);
  assign p9  = p15 ? 1'bz : ~(p1 ? p10 : p11);
  assign p12 = p15 ? 1'bz : ~(p1 ? p13 : p14);
endmodule

// --- 74LS295B  4-bit shift register, 3-state outputs -------------- К555ИР16 --
//   1=SER 2..5=A..D  6=MODE (1 = parallel load)  8=OE (1 = outputs driven)
//   9=CLK (falling edge)  13,12,11,10 = QA..QD
// --- 74LS298  quad 2-input multiplexer with storage --------------- К555КП13 --
//   10=WS word select (0 -> "1" inputs)  11=CLK (falling edge)
//   pairs: QA(15)<-A1(3)/B1(4)  QB(14)<-A2(2)/B2(1)
//          QC(13)<-C1(9)/C2(5)  QD(12)<-D1(7)/D2(6)
// Quad 2-port register.  The four channels are A..D and the two ports 1 and 2:
//   A1=3  B1=4  C1=9  D1=7   -> port 1
//   A2=2  B2=1  C2=5  D2=6   -> port 2
//   Q1=15 Q2=14 Q3=13 Q4=12
// Pins 1..7 are not two tidy groups, so it is easy to pair them wrongly -- and
// the wrong pairing is nearly invisible.  On this board D61 is the port $FE
// latch, holding each output through port 1 and loading D0..D3 through port 2;
// swapping pins 2 and 4 makes the border bit recirculate a different bit
// instead of ever loading D0, so it never leaves its power-on value and the
// blue channel stays undefined.

// -----------------------------------------------------------------------------
// CD4000B-series parts used by Krasnodar-48 (К561 originals).
// Ports are named after the DIP pin; supply pins are present but unused.
// -----------------------------------------------------------------------------
`timescale 1ns / 1ps

// --- CD4001B  quad 2-input NOR ------------------------------------ К561ЛЕ5 --
//   (1,2)->3   (5,6)->4   (8,9)->10   (12,13)->11
module cd4001 (input p1, p2, p5, p6, p8, p9, p12, p13,
               output p3, p4, p10, p11,
               input p7, p14);
  assign p3  = ~(p1  | p2);
  assign p4  = ~(p5  | p6);
  assign p10 = ~(p8  | p9);
  assign p11 = ~(p12 | p13);
endmodule

// --- CD4011B  quad 2-input NAND ----------------------------------- К561ЛА7 --
module cd4011 (input p1, p2, p5, p6, p8, p9, p12, p13,
               output p3, p4, p10, p11,
               input p7, p14);
  assign p3  = ~(p1  & p2);
  assign p4  = ~(p5  & p6);
  assign p10 = ~(p8  & p9);
  assign p11 = ~(p12 & p13);
endmodule

// --- CD4069UB  hex inverter --------------------------------------- К561ЛН2 --
module cd4069 (input p1, p3, p5, p9, p11, p13,
               output p2, p4, p6, p8, p10, p12,
               input p7, p14);
  assign p2  = ~p1;
  assign p4  = ~p3;
  assign p6  = ~p5;
  assign p8  = ~p9;
  assign p10 = ~p11;
  assign p12 = ~p13;
endmodule

// --- CD4013B  dual D flip-flop ------------------------------------ К561ТМ2 --
//   1=Q1 2=/Q1 3=CLK1 4=RST1 5=D1 6=SET1
//   13=Q2 12=/Q2 11=CLK2 10=RST2 9=D2 8=SET2      (RST/SET are active high)
// Pinout.  The first half follows the CD4013, the second half does NOT:
//   FF1  1=Q1  2=/Q1  3=CLK1  4=RESET1  5=D1  6=SET1
//   FF2 13=Q2 12=/Q2 11=CLK2 10=RESET2  9=D2  8=SET2
// A CD4013 has 12=Q2, 11=/Q2, 10=CLK2, 13=RESET2.  The К561ТМ2 symbol in the
// board's own library is pinned as above, and the circuit only makes sense
// that way: D34's pin 13 drives N$125, which pin 5 then reads back, and pin 11
// takes V3 through R22.  Read as a CD4013 instead, N$125 has no driver at all
// and the vertical timing chain stops -- which is exactly what happened when
// this was "corrected" to the datasheet.
// --- CD4015B  dual 4-stage static shift register ------------------ К561ИР2 --
//   A: 1=CLK 7=DATA 6=RST  outputs 5,4,3,2 = Q1..Q4
//   B: 9=CLK 15=DATA 14=RST outputs 13,12,11,10 = Q1..Q4
// The two halves are interleaved in the package, which is easy to get wrong:
//   A:  CLOCK 9   RESET 6   DATA 7    Q1..Q4 = 5, 4, 3, 10
//   B:  CLOCK 1   RESET 14  DATA 15   Q1..Q4 = 13, 12, 11, 2
// Only Q4 crosses over -- A's is 10, next to B's outputs, and B's is 2, next
// to A's.  Pairing 1 with 6/7 and 9 with 14/15 instead leaves D35 shifting on
// the wrong edge and the line counter never reaches the sync comparator.
// --- CD4520B  dual 4-bit binary up counter ------------------------ К561ИЕ10 --
//   A: 1=CLK 2=EN 7=RST  outputs 3,4,5,6 = Q0..Q3
//   B: 9=CLK 10=EN 15=RST outputs 11,12,13,14 = Q0..Q3
//   Counts on a rising CLK while EN is high, or on a falling EN while CLK is low.

// Synchronous replacements for parts of lib/ttl.v, used only in the FPGA
// build.  mk_synth_lib.py drops the lib/ttl.v definitions of these modules
// and appends this file to lib_sync.v, so regenerating lib_sync.v (which
// happens whenever lib/ttl.v changes) can no longer silently lose them.
//
// Each one replaces a capture on a board-generated strobe edge -- a race on
// real TTL won by a gate delay, lost on an FPGA -- with an edge detect on
// clk_sys.  bus_resolve.py wires the clk_sys port up automatically.

module ttl_74253 (input p14, p2, p1, p6, p5, p4, p3, p15, p10, p11, p12, p13,
                  output p7, p9,
                  input p8, p16,
                  input clk_sys);             // wired up automatically by bus_resolve.py
  // On this board the four '253s are the DRAM address multiplexers, and their
  // low select (p14) is /RAS itself: high presents the row, low the column.
  // Real DRAM latches the row as /RAS falls, and it is the multiplexer's own
  // propagation delay that keeps the row on the pins long enough.  The data
  // inputs, meanwhile, are counter bits that may change on the very tick that
  // makes /RAS fall -- and in hardware they settle *before* /RAS arrives,
  // which comes out of three more gates.
  //
  // So: data inputs pass straight through, but the select takes effect one
  // system clock late.  When the DRAM model sees /RAS fall it then reads the
  // row with every counter bit already updated, and only afterwards does the
  // multiplexer switch to the column for /CAS.  Without this the model took
  // the column as the row (54 distinct video addresses a frame); sampling one
  // clock early instead took stale counter bits (68 rows of 128).
  reg [1:0] sel = 2'b00;
  always @(posedge clk_sys) sel <= {p2, p14};
  wire d1 = (sel == 2'd0) ? p6 : (sel == 2'd1) ? p5 : (sel == 2'd2) ? p4 : p3;
  wire d2 = (sel == 2'd0) ? p10 : (sel == 2'd1) ? p11 : (sel == 2'd2) ? p12 : p13;
  assign p7 = p1  ? 1'bz : d1;
  assign p9 = p15 ? 1'bz : d2;
endmodule

module ttl_74175 (input p1, p4, p5, p9, p12, p13,
                  output p2, p3, p6, p7, p10, p11, p14, p15,
                  input p8, p16,
                  input clk_sys);             // wired up automatically by bus_resolve.py
  // Quad D flip-flop, rising edge of p9, /CLR on p1.  On this board it is the
  // attribute latch, clocked by VDC (N_108 through an RC delay) and taking the
  // DRAM data bus.  Clocked directly by VDC it was a separately routed clock
  // with its own skew against the bus: fine in simulation, wrong attributes on
  // the Tang Nano 20K (black paper, blue ink where the test ROM writes 0x38).
  // So detect the edge on clk_sys and capture there, which behaves the same in
  // simulation and on the FPGA.
  reg [3:0] q = 4'b0;
  reg ck_d = 1'b0;
  always @(posedge clk_sys) begin
    ck_d <= p9;
    if (!p1)               q <= 4'b0;
    else if (!ck_d && p9)  q <= {p13, p12, p5, p4};
  end
  assign {p2, p3}   = { q[0], ~q[0]};
  assign {p7, p6}   = { q[1], ~q[1]};
  assign {p10, p11} = { q[2], ~q[2]};
  assign {p15, p14} = { q[3], ~q[3]};
endmodule

module ttl_74295 (input p1, p2, p3, p4, p5, p6, p8, p9,
                  output p13, p12, p11, p10,
                  input p7, p14,
                  input clk_sys);             // wired up automatically by bus_resolve.py
  // 4-bit shift register, falling edge of p9; p6 high = parallel load.  On
  // this board these are the pixel shifters, clocked by VCLK and F3_5M --
  // board-generated signals that, used as FPGA clocks, are routed with their
  // own skew against the data they take.  Edge detected on clk_sys instead,
  // so simulation and hardware agree cycle for cycle.
  reg [3:0] q = 4'b0;
  reg ck_d = 1'b0;
  always @(posedge clk_sys) begin
    ck_d <= p9;
    if (ck_d && !p9) begin
      if (p6) q <= {p5, p4, p3, p2};        // parallel load  (QA..QD <= A..D)
      else    q <= {q[2:0], p1};            // shift right    (SER -> QA)
    end
  end
  assign p13 = p8 ? q[0] : 1'b1;   // QA
  assign p12 = p8 ? q[1] : 1'b1;   // QB
  assign p11 = p8 ? q[2] : 1'b1;   // QC
  assign p10 = p8 ? q[3] : 1'b1;   // QD
endmodule

module ttl_74298 (input p1, p2, p3, p4, p5, p6, p7, p9, p10, p11,
                  output p12, p13, p14, p15,
                  input p8, p16,
                  input clk_sys);             // wired up automatically by bus_resolve.py
  // A '298 stores on the HIGH-to-LOW edge of its clock (p11), taking port 2
  // when the select (p10) is high.  On this board the clock is WR and the
  // select is WR6 = ~(/IORQ | A0): both end together at the close of an OUT,
  // so on real TTL the select and the data survive the edge only by a gate
  // delay.  On an FPGA that race goes whichever way the routing falls -- the
  // Tang Nano 20K came up with a blue border (001) where the ROM writes white
  // (111).  So track select and both ports on the system clock while the
  // strobe is still high, and on its falling edge commit the last values seen
  // before it fell.
  reg [3:0] q    = 4'b0;                      // {Q4, Q3, Q2, Q1}
  reg [3:0] d1_r = 4'b0, d2_r = 4'b0;
  reg       sel_r = 1'b0, ck_d = 1'b0;
  always @(posedge clk_sys) begin
    ck_d <= p11;
    if (p11) begin
      sel_r <= p10;
      d2_r  <= {p6, p5, p1, p2};              // port 2: D2 C2 B2 A2
      d1_r  <= {p7, p9, p4, p3};              // port 1: D1 C1 B1 A1
    end
    if (ck_d && !p11) q <= sel_r ? d2_r : d1_r;
  end
  assign {p12, p13, p14, p15} = q;
endmodule

module cd4013 (input p3, p4, p5, p6, p8, p9, p10, p11,
               output p1, p2, p12, p13,
               input p7, p14,
               input clk_sys);                // wired up automatically by bus_resolve.py
  // Dual D flip-flop: rising clock (3, 11), active-high reset (4, 10) and set
  // (6, 8).  Clock edges are detected on clk_sys; reset and set are
  // asynchronous on the real part and stay so here, as gating on the outputs
  // (and they clear the stored state on clk_sys).  Applying them a clock late
  // instead let D34's reset, V5, arrive 7 ns after V3 -- which changes on the
  // same counter tick -- and SSI = NAND(~V3, Q) glitched low for that 7 ns:
  // two line syncs per line, and the scan doubler never locked.
  reg q1 = 1'b0, q2 = 1'b0;
  reg c1_d = 1'b1, c2_d = 1'b1;
  always @(posedge clk_sys) begin
    c1_d <= p3;
    c2_d <= p11;
    if (p4)                  q1 <= 1'b0;
    else if (p6)             q1 <= 1'b1;
    else if (!c1_d && p3)    q1 <= p5;
    if (p10)                 q2 <= 1'b0;
    else if (p8)             q2 <= 1'b1;
    else if (!c2_d && p11)   q2 <= p9;
  end
  wire o1 = p4  ? 1'b0 : p6 ? 1'b1 : q1;
  wire o2 = p10 ? 1'b0 : p8 ? 1'b1 : q2;
  assign p1  =  o1;
  assign p2  = ~o1;
  assign p13 =  o2;
  assign p12 = ~o2;
endmodule

module cd4015 #(parameter integer TPLH = 40,  // clk_sys ticks: rising outputs, ~300 ns
                parameter integer TPHL = 33)  // falling outputs, ~245 ns
              (input p1, p7, p6, p9, p15, p14,
               output p5, p4, p3, p2, p13, p12, p11, p10,
               input p8, p16,
               input clk_sys);                // wired up automatically by bus_resolve.py
  // Dual 4-stage shift register: rising clock (9, 1), active-high reset
  // (6, 14).  Clock edges detected on clk_sys; the reset clears the stage
  // outputs directly, as on the real part (see cd4013 above), ahead of the
  // propagation delay below.
  reg [3:0] a = 4'b0, b = 4'b0;
  reg ca_d = 1'b1, cb_d = 1'b1;
  always @(posedge clk_sys) begin
    ca_d <= p9;
    cb_d <= p1;
    if (p6)                  a <= 4'b0;
    else if (!ca_d && p9)    a <= {a[2:0], p7};
    if (p14)                 b <= 4'b0;
    else if (!cb_d && p1)    b <= {b[2:0], p15};
  end
  wire [3:0] ao = p6  ? 4'b0 : a;
  wire [3:0] bo = p14 ? 4'b0 : b;

  // A CD4015 at 5 V takes 250-400 ns from clock to output, and this board
  // depends on it.  D35's second half makes the horizontal display window
  // (O18_3 = NOR of its Q3 and Q4, among others), which opens and closes on
  // the same character-clock edges that start video fetches -- and which also
  // releases the preset of the CPU-arbitration flip-flop, D10, clocked by N_55
  // every 20 ticks.  Three things then depend on the delay:
  //   * closing: the 32nd character's fetch (its pixel strobe ~30 ticks after
  //     its slot edge) must finish first, or column 31 shows the idle bus --
  //     bright white garbage.  Needs the *rising* output delay >= ~40.
  //   * opening: the window must be open just *before* an N_55 edge, or the
  //     CPU's /MREQ can fall the same instant and the arbitration misses it;
  //     the CPU write then meets a video fetch (after the reset button, the
  //     memory test failed).  Needs the *falling* output delay <= 34.
  //   * opening, again: the video sequencer (D17) samples the window on F3_5M;
  //     at 53 it missed its edge and the fetches slid into the CPU's slots.
  // The window opens when the outputs fall and closes when one rises, and
  // real CMOS has different rise and fall delays (tPLH, tPHL), so each gets
  // its own: out = (copy delayed TPLH) AND (copy delayed TPHL), which rises
  // with the later and falls with the earlier.
  reg [7:0] dl [0:TPLH-1];
  integer k;
  always @(posedge clk_sys) begin
    dl[0] <= {ao, bo};
    for (k = 1; k < TPLH; k = k + 1) dl[k] <= dl[k-1];
  end
  wire [7:0] dout = dl[TPLH-1] & dl[TPHL-1];
  assign {p10, p3, p4, p5}    = dout[7:4];   // Q4 Q3 Q2 Q1
  assign {p2, p11, p12, p13}  = dout[3:0];
endmodule
