nechet/zx-spectrum-fpga-tang-nano-20k/Krasnodar-48-fpga/Verilog/synth/z80_chip.v

// -----------------------------------------------------------------------------
// Z80 CPU in a 40-pin DIP wrapper (D1 on this board).
//
// The core is TV80 by Guy Hutchison -- a Verilog port of Daniel Wallner's T80 --
// vendored under third_party/tv80/ (MIT licence).  TV80 presents separate `di`
// and `dout` buses; this wrapper adds the bidirectional data bus and maps
// everything onto real Z80 pin numbers:
//
//   A0..A15 = 30,31,32,33,34,35,36,37,38,39,40,1,2,3,4,5
//   D0..D7  = 14,15,12,8,7,9,10,13
//   6=CLK 16=/INT 17=/NMI 18=/HALT 19=/MREQ 20=/IORQ 21=/RD 22=/WR
//   23=/BUSAK 24=/WAIT 25=/BUSRQ 26=/RESET 27=/M1 28=/RFSH
// -----------------------------------------------------------------------------
// -----------------------------------------------------------------------------
// FPGA build of the Z80 (D1).  Same pins as lib/z80_chip.v, plus clk_sys.
//
// lib/z80_chip.v clocks TV80 directly from the board's CLK pin.  On the FPGA
// that CLK is made in logic (7474 dividers and gates), so it reaches the
// core's ~1000 flip-flops over ordinary routing, with build-dependent skew
// against the 135 MHz logic that drives the data bus.  Gowin's report showed
// it as a derived clock with 233 failing endpoints; on the Tang Nano 20K the
// ROM booted to WAIT-KEY and then crashed -- a different place every build.
//
// Here the core runs on clk_sys and advances only on a detected edge of CLK
// (TV80's clock enable), so there is one clock in the whole design.  See
// tv80n_sync at the end of this file.
// -----------------------------------------------------------------------------
`timescale 1ns / 1ps

module z80_chip (
    output p30, p31, p32, p33, p34, p35, p36, p37,     // A0..A7
    output p38, p39, p40, p1, p2, p3, p4, p5,          // A8..A15
    inout  p14, p15, p12, p8, p7, p9, p10, p13,        // D0..D7
    input  p6,                                          // CLK
    input  p16, p17, p24, p25, p26,                     // /INT /NMI /WAIT /BUSRQ /RESET
    output p18, p19, p20, p21, p22, p23, p27, p28,      // /HALT /MREQ /IORQ /RD /WR /BUSAK /M1 /RFSH
    input  p11, p29,
    input  clk_sys);             // wired up automatically by bus_resolve.py

  wire [15:0] a;
  wire [7:0]  dout;
  wire [7:0]  di = {p13, p10, p9, p7, p8, p12, p15, p14};
  wire mreq_n, iorq_n, rd_n, wr_n, m1_n, rfsh_n, halt_n, busak_n;

  // T2Write(0): /WR asserted from the falling clock edge in T2 to the one in
  // T3, which is the real Z80's write strobe.  T2Write(1) asserts it from the
  // falling edge in T1 -- half a clock before tv80 loads dout at the end of T1
  // -- so the start of every write strobe carried the previous byte.  This
  // board's DRAM does late writes, committing at the first instant /RAS, /CAS
  // and /WE are all low, which landed in that half clock: the test ROM's
  // LD (HL),38h stored 02 (the last byte read), and every screen write was
  // wrong on hardware and in simulation alike.
  tv80n_sync #(.Mode(0), .T2Write(0), .IOWait(1)) core (
      .clk_sys (clk_sys),
      .reset_n (p26),
      .clk     (p6),
      .wait_n  (p24),
      .int_n   (p16),
      .nmi_n   (p17),
      .busrq_n (p25),
      .di      (di),
      .m1_n    (m1_n),
      .mreq_n  (mreq_n),
      .iorq_n  (iorq_n),
      .rd_n    (rd_n),
      .wr_n    (wr_n),
      .rfsh_n  (rfsh_n),
      .halt_n  (halt_n),
      .busak_n (busak_n),
      .A       (a),
      .dout    (dout));

  assign {p37, p36, p35, p34, p33, p32, p31, p30} = a[7:0];    // A7..A0
  assign {p5, p4, p3, p2, p1, p40, p39, p38}      = a[15:8];   // A15..A8

  // The CPU only drives the data bus while it is writing; the rest of the time
  // it is released so the ROM, RAM, PPI and multiplexers can drive it.
  //
  // /BUSAK is active low and idles HIGH, like the /MREQ and /RD gating just
  // below.  Writing ~busak_n here made the term permanently zero, so the CPU
  // never drove the bus at all: every write went out as FF -- the value of an
  // idle wired-AND bus -- while addresses, /WR and timing all looked perfect.
  // The machine got as far as initialising its system variables and then
  // filled them, the stack and the screen with FF.
  wire drive = ~wr_n & busak_n;
  assign {p13, p10, p9, p7, p8, p12, p15, p14} = drive ? dout : 8'bz;

  assign p18 = halt_n;
  assign p19 = busak_n ? mreq_n : 1'bz;
  assign p20 = busak_n ? iorq_n : 1'bz;
  assign p21 = busak_n ? rd_n   : 1'bz;
  assign p22 = busak_n ? wr_n   : 1'bz;
  assign p23 = busak_n;
  assign p27 = m1_n;
  assign p28 = rfsh_n;
endmodule


// -----------------------------------------------------------------------------
// tv80n, rewritten for a single clock.  third_party/tv80/tv80n.v is unchanged;
// this follows it line for line except:
//   * posedge clk          ->  clk_sys with cen = "CLK has just risen"
//   * negedge clk          ->  clk_sys when "CLK has just fallen"
//   * /INT /NMI /WAIT /BUSRQ /RESET are synchronised and then only allowed to
//     change on CLK's falling edge, so they are steady at the rising edge where
//     the core samples them.  /INT comes from a 14 MHz-clocked pulse and CLK
//     is derived from the same 14 MHz, so unsynchronised it can change on the
//     very sampling edge -- and fan out to many flip-flops that then disagree.
//     A real Z80 has its own input latches; this is their equivalent.
// The core reacts four clk_sys (~30 ns) after each CLK edge -- inside a
// real Z80's own 60-100 ns output delays.
// -----------------------------------------------------------------------------
module tv80n_sync #(parameter Mode = 0, parameter T2Write = 0, parameter IOWait = 1) (
    input  wire        clk_sys,
    input  wire        clk,
    input  wire        reset_n, wait_n, int_n, nmi_n, busrq_n,
    input  wire [7:0]  di,
    output wire        m1_n,
    output reg         mreq_n = 1'b1,
    output reg         iorq_n = 1'b1,
    output reg         rd_n   = 1'b1,
    output reg         wr_n   = 1'b1,
    output wire        rfsh_n, halt_n, busak_n,
    output wire [15:0] A,
    output wire [7:0]  dout);

  // CLK edges.  CLK comes out of the 14 MHz-clocked 7474/74193 chain, not
  // from clk_sys registers, so it is synchronised first, and the edges are
  // derived from synchronised copies only.  The first version used the raw CLK
  // in `rise` -- an asynchronous signal straight into the clock enable of
  // ~1000 flip-flops.  When CLK changed near a clk_sys edge, some flip-flops
  // stepped and others did not; on the 20K the CPU never got as far as its
  // first OUT.  Simulation, with no routing delay, could not show it.
  reg clk_s1 = 1'b0, clk_s2 = 1'b0, clk_d = 1'b0;
  reg rise = 1'b0, fall = 1'b0;
  always @(posedge clk_sys) begin
    clk_s1 <= clk;
    clk_s2 <= clk_s1;
    clk_d  <= clk_s2;
    rise   <=  clk_s2 & ~clk_d;      // registered: one clean enable for all
    fall   <= ~clk_s2 &  clk_d;
  end

  // Control inputs: two-stage synchroniser, then held from one CLK fall to
  // the next.
  reg [4:0] in_s1 = 5'b11111, in_s2 = 5'b11111, in_q = 5'b11111;
  always @(posedge clk_sys) begin
    in_s1 <= {reset_n, wait_n, int_n, nmi_n, busrq_n};
    in_s2 <= in_s1;
    if (fall) in_q <= in_s2;
  end
  wire reset_q = in_q[4], wait_q = in_q[3], int_q = in_q[2],
       nmi_q = in_q[1], busrq_q = in_q[0];

  reg        nxt_mreq_n, nxt_iorq_n, nxt_rd_n, nxt_wr_n;
  wire       intcycle_n, no_read, write, iorq;
  reg  [7:0] di_reg = 8'h00;
  wire [6:0] mcycle, tstate;

  tv80_core #(Mode, IOWait) i_tv80_core (
     .cen (rise),
     .m1_n (m1_n), .iorq (iorq), .no_read (no_read), .write (write),
     .rfsh_n (rfsh_n), .halt_n (halt_n),
     .wait_n (wait_q), .int_n (int_q), .nmi_n (nmi_q),
     .reset_n (reset_q), .busrq_n (busrq_q), .busak_n (busak_n),
     .clk (clk_sys),
     .IntE (), .stop (),
     .A (A), .dinst (di), .di (di_reg), .dout (dout),
     .mc (mcycle), .ts (tstate), .intcycle_n (intcycle_n));

  always @* begin
    nxt_mreq_n = 1; nxt_rd_n = 1; nxt_iorq_n = 1; nxt_wr_n = 1;
    if (mcycle[0]) begin
      if (tstate[1] || tstate[2]) begin
        nxt_rd_n   = ~intcycle_n;
        nxt_mreq_n = ~intcycle_n;
        nxt_iorq_n = intcycle_n;
      end
    end else begin
      if ((tstate[1] || tstate[2]) && !no_read && !write) begin
        nxt_rd_n   = 1'b0;
        nxt_iorq_n = ~iorq;
        nxt_mreq_n = iorq;
      end
      if (T2Write == 0) begin
        // A real Z80 asserts /MREQ for a memory write at the falling edge in
        // T1, and /WR a clock later in T2.  tv80n asserts both in T2, half a
        // clock late for /MREQ.  This board's arbitration decides on the CPU
        // look-ahead around T1, so a late /MREQ could fall at the very moment
        // the video window opened: the CPU was not held, its write met a video
        // fetch and landed in the video's DRAM row.  Whether it happened
        // depended on the CPU's phase against the video -- right after
        // configuration it never did, after the reset button mostly it did.
        if ((tstate[1] || tstate[2]) && write && !iorq)
          nxt_mreq_n = 1'b0;
        if (tstate[2] && write) begin
          nxt_wr_n   = 1'b0;
          nxt_iorq_n = ~iorq;
          nxt_mreq_n = iorq;
        end
      end else begin
        if ((tstate[1] || (tstate[2] && !wait_q)) && write) begin
          nxt_wr_n   = 1'b0;
          nxt_iorq_n = ~iorq;
          nxt_mreq_n = iorq;
        end
      end
    end
  end

  always @(posedge clk_sys) if (fall) begin       // was: negedge clk
    if (!reset_q) begin
      rd_n <= 1'b1; wr_n <= 1'b1; iorq_n <= 1'b1; mreq_n <= 1'b1;
    end else begin
      rd_n <= nxt_rd_n; wr_n <= nxt_wr_n; iorq_n <= nxt_iorq_n; mreq_n <= nxt_mreq_n;
    end
  end

  always @(posedge clk_sys) if (rise) begin       // was: posedge clk
    if (!reset_q)                     di_reg <= 8'h00;
    else if (tstate[2] && wait_q)     di_reg <= di;
  end
endmodule
